TaylorAndonian/esp32-homekit-lights/hardware/schematic.png

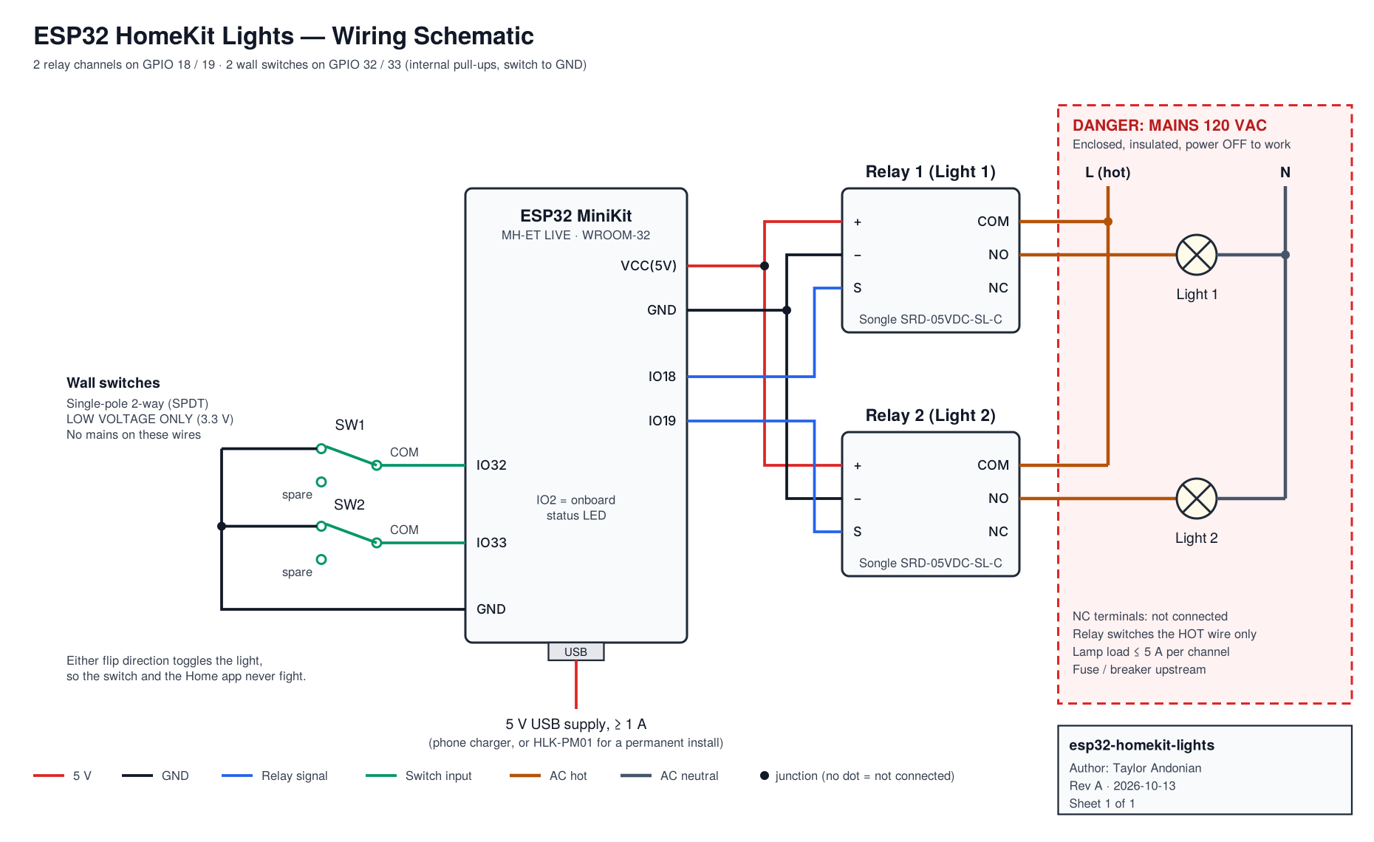
hardware/schematic.png
