TaylorAndonian/esp32-homekit-lights/hardware/enclosure/main_switch_box.step

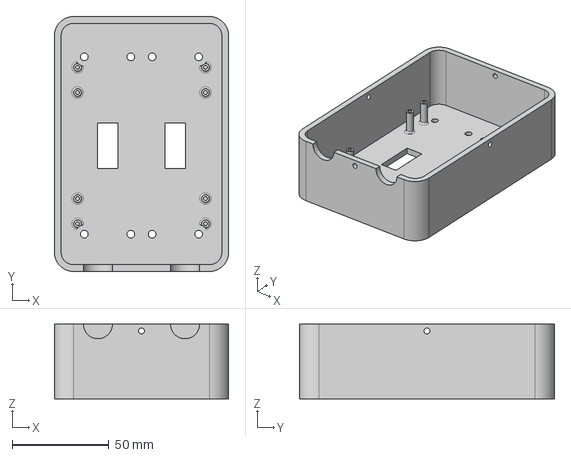
[picture p5: CAD file, 2026-10-14]
hardware/enclosure/main_switch_box.step
90.0 x 131.6 x 38.5 mm
