TaylorAndonian/esp32-homekit-lights/hardware/enclosure/switch_box_back.step

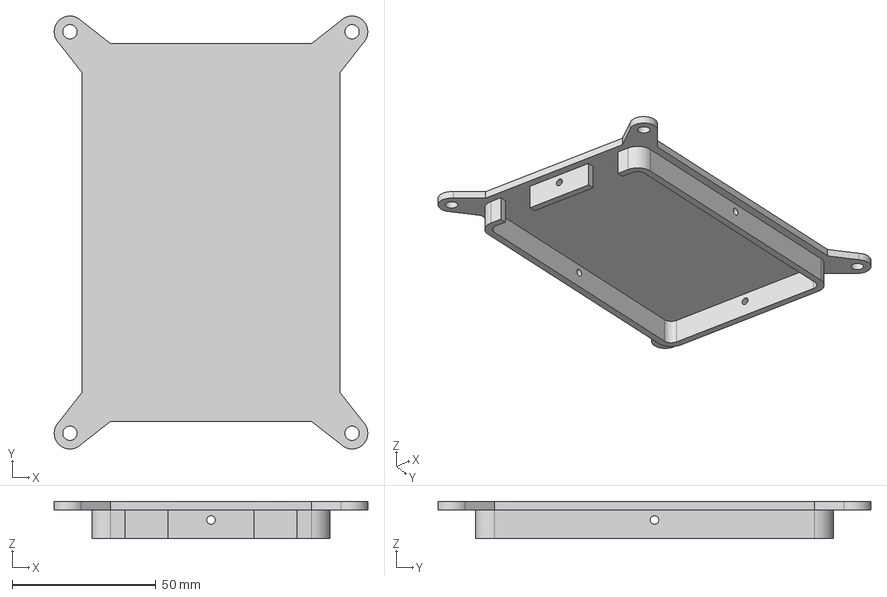
[picture p6: CAD file, 2026-10-14]
hardware/enclosure/switch_box_back.step
109.3 x 150.9 x 13.0 mm
